esl-epfl/HEEPokranios-breakout-board/README.md

# This repository contains the HEEPokranios breakout board
