esl-epfl/HEEPokranios-breakout-board/gpio-playground/jlcpcb/production_files/BOM_gpio-playground.csv

Comment | Designator | Footprint | LCSC | Qty
100n | C1 | C_0603_1608Metric | C30926 | 1
LED | D0,D1,D2,D3,D4,D5,D6,D7,D9 | LED_0603_1608Metric | C84263 | 9
Conn_02x03_Odd_Even | J1 | PinHeader_2x03_P2.54mm_Horizontal | C41417351 | 1
Conn_02x08_Odd_Even | J2 | PinHeader_2x08_P2.54mm_Horizontal | C41417356 | 1
50k | R1,R2,R3,R4,R5,R6,R7,R8 | R_0603_1608Metric | C861451 | 8
1k | R9,R10,R11,R12,R13,R14,R15,R16,R17,R18,R19 | R_0603_1608Metric | C110776 | 11
SW_Push | SW0,SW1,SW2,SW3,SW4,SW5,SW6,SW7 | SW_Push_1P1T_NO_CK_KMR2 | C72443 | 8
BIWIN_DTS04GE_SMD | U1,U2 | BIWIN_DTS04GE_SMD | C3294670 | 2
74AHC244 | U3 | TSSOP-20_4.4x6.5mm_P0.65mm | C7475 | 1
