esl-epfl/HEEPokranios-breakout-board/(commit log)

2025-09-27 Previous to changing connector to 2.54
    [heepidermis-bo.kicad_pcb, heepidermis-bo.kicad_sch]
2025-09-27 Finished adding the large connector. Missing gpios and qfn footprint
    [heepidermis-bo.kicad_pcb, heepidermis-bo.kicad_sch]
2025-09-30 Almost done adding footprint of qfn64
    [heepidermis-bo.kicad_sch]
2025-10-01 DRC clean
    [heepidermis-bo.kicad_pcb, heepidermis-bo.kicad_sch]
2025-10-01 Uploaded gerbers
    [BOM_heepidermis-bo.csv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]
2025-10-03 Added zskin
    [heepidermis-bo-B_Cu.gbr, heepidermis-bo-B_Mask.gbr, heepidermis-bo-B_Paste.gbr, heepidermis-bo-B_Silkscreen.gbr, heepidermis-bo-Edge_Cuts.gbr, heepidermis-bo-F_Cu.gbr, heepidermis-bo-F_Mask.gbr, heepidermis-bo-F_Paste.gbr]
2025-11-18 Cleander repo
    [BOM_heepidermis-bo.csv, HEEPocrates.kicad_sch, LED_driver.kicad_sch, LevelTransMeasCurrent.kicad_sch, PowerHTB.kicad_sch, Programmer.kicad_sch, adc-dac.kicad_pcb, adc-dac.kicad_sch]
2026-07-14 further cleaning
    [BOM_heepidermis-bo.csv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]
2026-07-14 Added symbol and footprint of cheep boards connector
    [heepokranios-bo.kicad_sch]
2026-07-15 Initial draft of the schematic
    [heepokranios-bo.kicad_sch]
2026-07-15 Initial floorplannig
    [heepokranios-bo.kicad_sch]
2026-07-17 In the process of floorplanning the pcb
    [heepokranios-bo.kicad_pcb]
2026-07-17 Initial floorplanning
    [heepokranios-bo.kicad_pcb]
2026-07-17 Added GPIO playground extension board
    [gpio-playground.kicad_pcb, gpio-playground.kicad_sch, heepokranios-bo.kicad_pcb, heepokranios-bo.kicad_sch]
2026-07-17 Added gpio playground PCB
    [gpio-playground.kicad_pcb, gpio-playground.kicad_sch]
2026-07-17 Added first draft of portenta's extension board
    [portenta.kicad_pcb, portenta.kicad_sch]
2026-07-20 Adding sch block for analog fully-differential buffer
    [analog_buffers.kicad_sch]
2026-07-20 Added draft floorplan of portenta board
    [portenta.kicad_pcb, portenta.kicad_sch]
2026-07-20 notes on the portenta
    [portenta.kicad_pcb, portenta.kicad_sch]
2026-07-22 Added floorplan and outline of breakout board
    [fd_buffer.kicad_sch, heepokranios-bo.kicad_pcb, heepokranios-bo.kicad_sch, portenta.kicad_pcb, se_buffer.kicad_sch]
2026-07-22 Cheep connector (connections to main board): revised, modified 3V3 pin and added references to their values. Also modified the circuit to the current pins (resistor values + new pin headers)
    [heepokranios-bo.kicad_sch]
2026-07-23 Completed layout of the breakout board
    [heepokranios-bo.kicad_sch]
2026-07-23 Added logos to breakout
    [heepokranios-bo.kicad_sch]
2026-07-24 Updated connector on bo
    [gpio-playground.kicad_pcb, gpio-playground.kicad_sch, heepokranios-bo.kicad_sch]
2026-07-24 Corrected the pin connections of the playground
    [gpio-playground.kicad_pcb, gpio-playground.kicad_sch]
2026-07-24 Filled zones
    [gpio-playground.kicad_pcb]
2026-07-24 Revised connections between DMUX pins and Portenta
    [portenta.kicad_sch]
2026-07-27 Added matching circuit for antenna connector, and additional buffer for inputing SE and measuring FD
    [fd_buffer.kicad_sch, heepokranios-bo.kicad_pcb, heepokranios-bo.kicad_sch]
2026-07-27 Added 3d model of connector
    [heepokranios-bo.kicad_pcb]
2026-07-27 Added some 3d models to the PCB of the GPIO playground, not the real ones tho
    [gpio-playground.kicad_pcb]
2026-07-27 Placement in Portenta board, ready to route
    [portenta.kicad_pcb, portenta.kicad_sch]
2026-07-27 Layout of portenta board
    [portenta.kicad_pcb, portenta.kicad_sch]
2026-07-28 Portenta board: Edited footprints and added BOM for LCSC
    [BOM_portenta.csv, portenta.kicad_pcb, portenta.kicad_sch]
2026-07-28 GPIO playground board: Edited footprints and added BOM for LCSC
    [BOM_gpio-playground.csv]
2026-07-28 HEEPokranios breakout board: Added BOM for LCSC for all components except some pin headers and the chip socket
    [heepokranios-bo.csv]
2026-07-31 Changed NC pins to gnd connections of substrate as per the bonding diagram
    [heepokranios-bo.kicad_pcb, heepokranios-bo.kicad_sch]
2026-08-07 Edited footprint of PGA 13x13 socket to include lever area that was previously missing. Also upated BOM to reflect new VREF_EN pull-down resistor and lower resistor for heartbeat LED
    [heepokranios-bo.csv]
2026-08-07 Routing with extended PGA 13x13 socket
    [heepokranios-bo.kicad_pcb, heepokranios-bo.kicad_sch]
2026-08-07 Re-routed with updated PGA 13x13 socket
    [heepokranios-bo.kicad_pcb]
2026-08-07 Re-routed dMUX 0-7 pins from chip as they were inverted
    [heepokranios-bo.kicad_pcb, heepokranios-bo.kicad_sch]
2026-08-07 Added production files (gerbers and CPL) for JLCPCB for the GPIO playground board
    [gpio-playground.kicad_pcb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]
2026-08-07 Portenta board: Fixed DRCs in board and added production files (gerbers and CPL) for JLCPCB
    [portenta.kicad_pcb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]
2026-08-07 GPIO playground board: Fixed DRCs and shorts in dMUX pin header connections, and re-generated production files (CPL and gerbers)
    [gpio-playground.kicad_pcb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]
2026-08-07 Main breakout board: Generated production files (CPL, gerber) for JLCPCB
    [BOM_heepokranios-bo.csv, heepokranios-bo.kicad_pcb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]
2026-08-12 Edited LCSC code for 3x3p male pin header
    [BOM_heepokranios-bo.csv]
2026-08-12 Changed in sch and board the fully diff amplifiers within the buffers to the THS4551IRGTR as there was no more stock of the one from Analog Devices
    [fd_buffer.kicad_sch, heepokranios-bo.kicad_pcb, se_buffer.kicad_sch]
2026-08-12 Updated production files for JLCPCB with the new fully differential amplifier for the buffers
    [BOM_heepokranios-bo.csv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]
2026-08-13 Changed push button model to one that has stock
    [BOM_gpio-playground.csv]
