esl-epfl/HEEPokranios-breakout-board/heepokranios-bo/heepokranios-bo.kicad_pcb

## KiCad design heepokranios-bo/heepokranios-bo.kicad_pcb (2026-08-12)

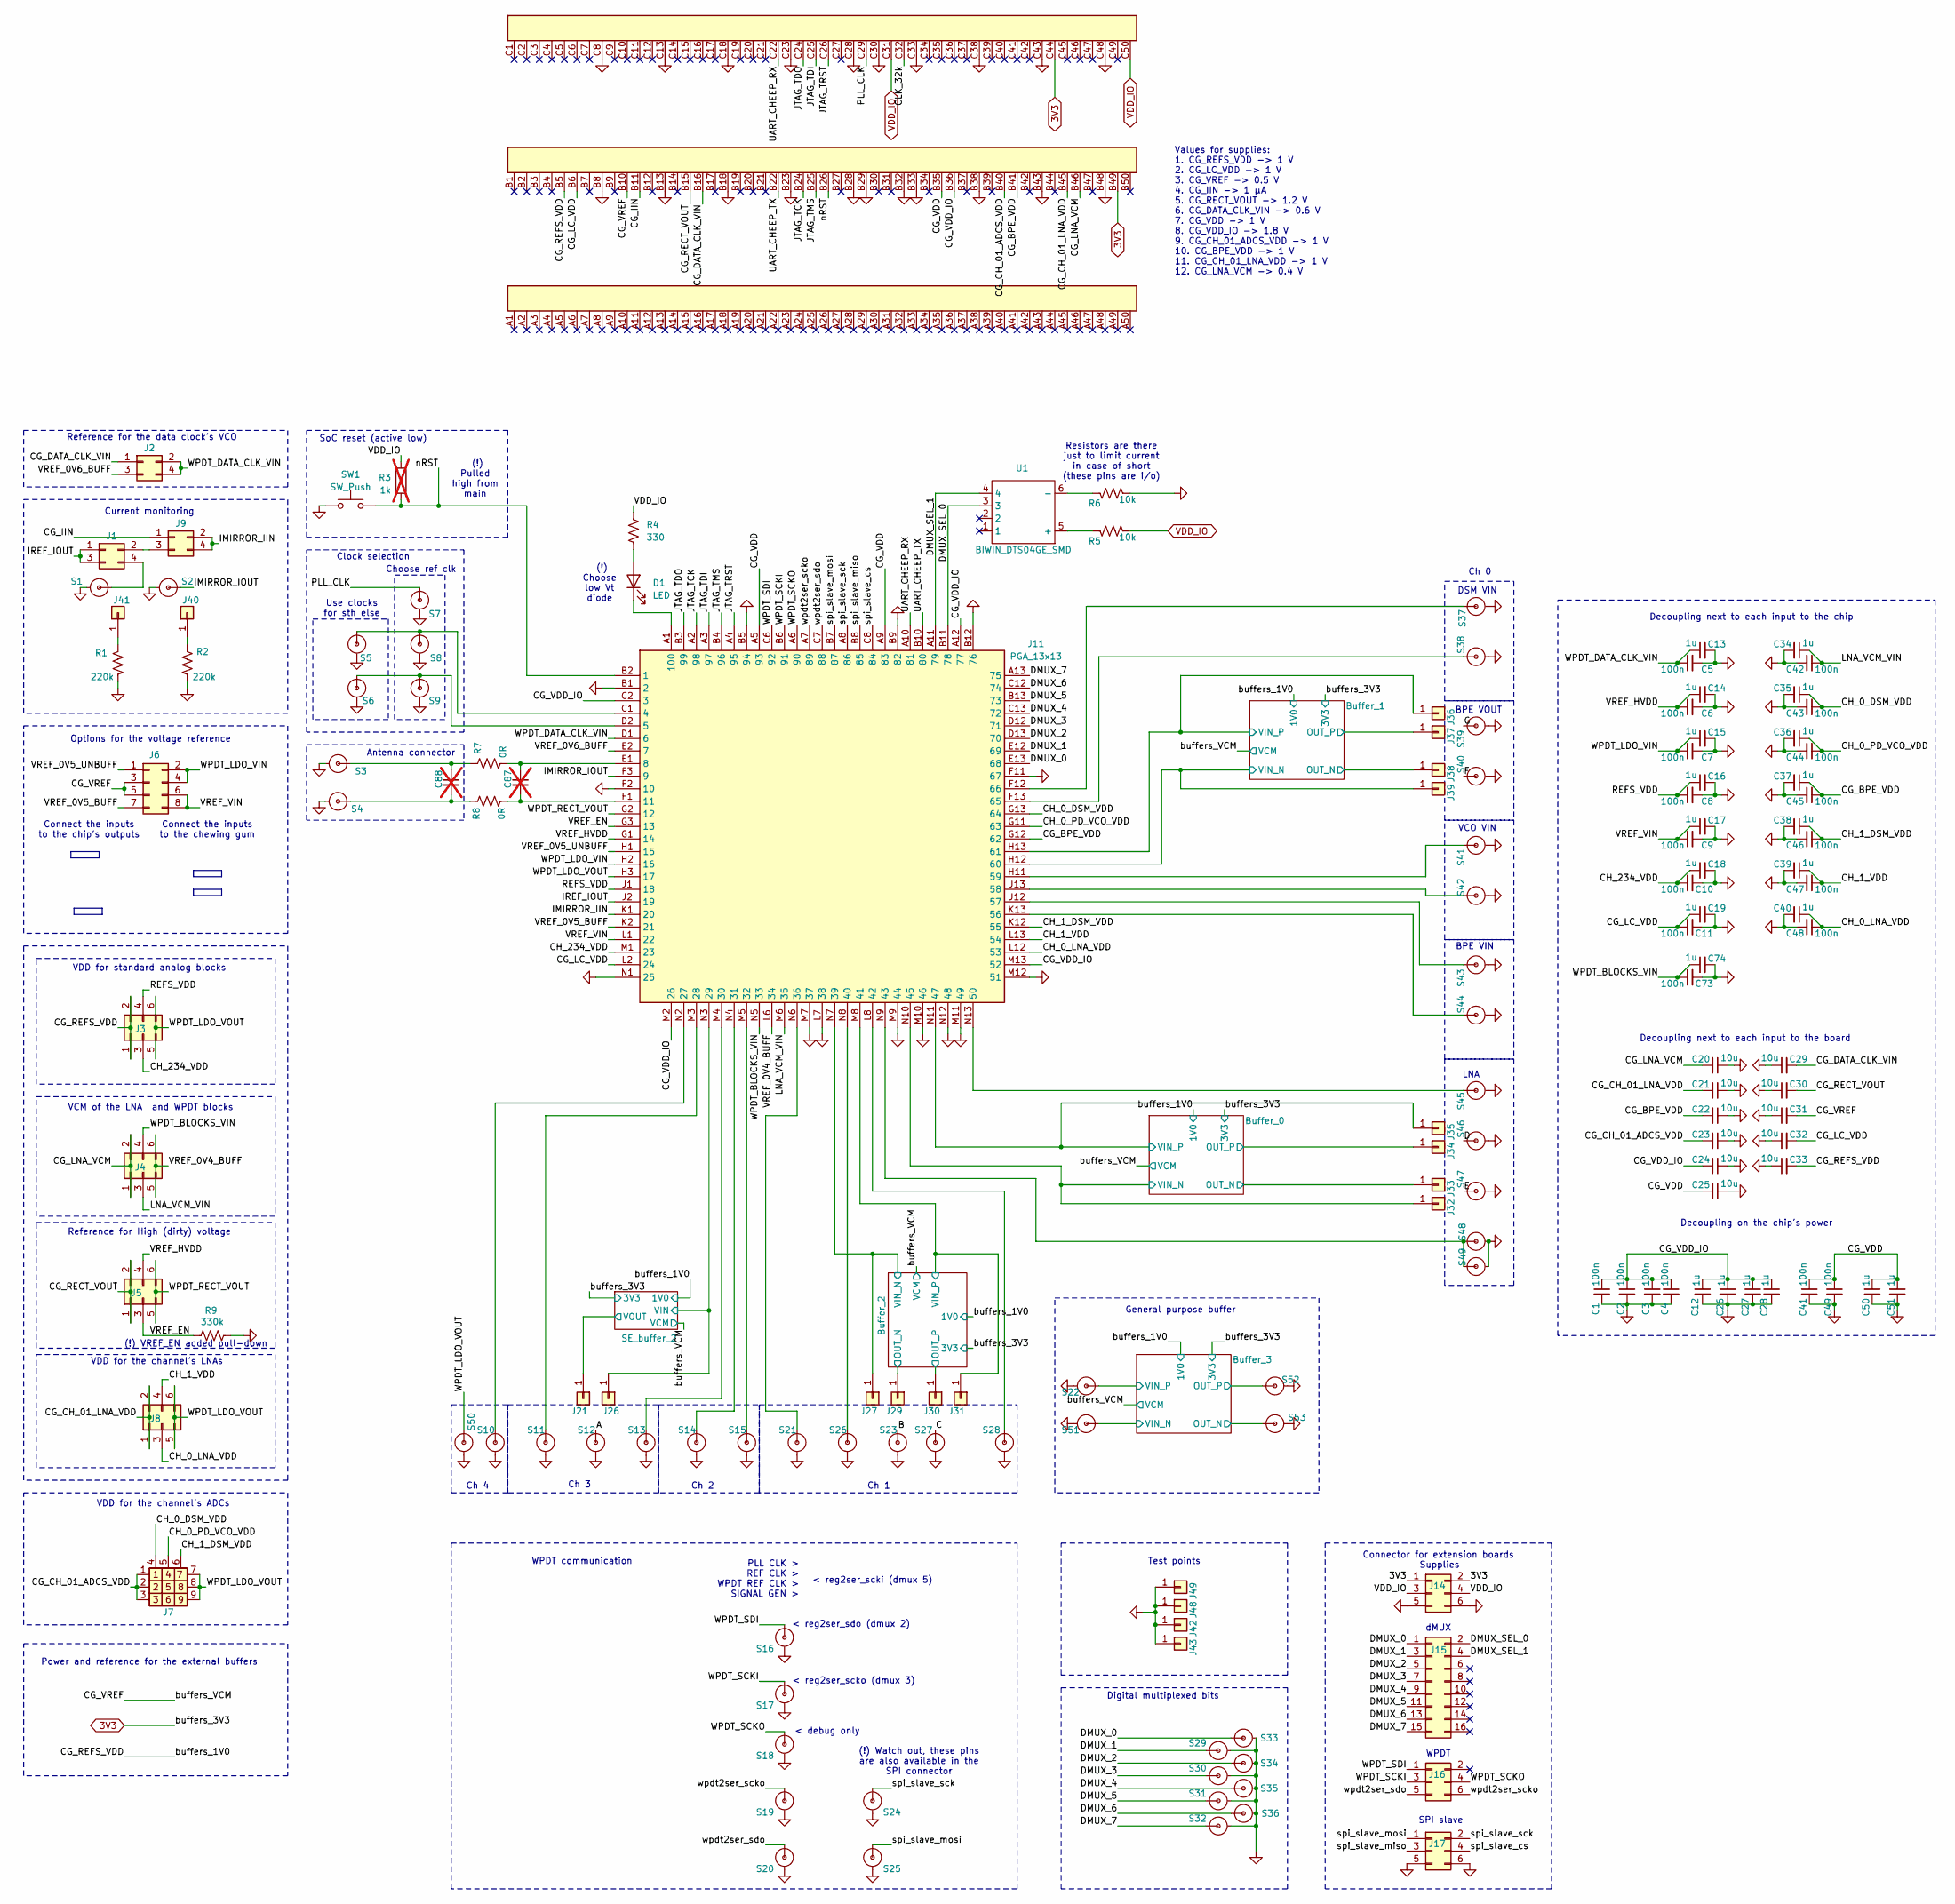
[picture p1: schematic heepokranios-bo.kicad_sch]

Parts:
C1, C2, C3, C4, C5, C6, C7, C8, C9, C10, C11, C41, C42, C43, C44, C45, C46, C47, C48, C49, C73: 100n; C_0603_1608Metric; Mouser Part Number 80-C0805C104Z3V; Digikey Part Number 399-9158-1-ND
C12, C13, C14, C15, C16, C17, C18, C19, C26, C27, C28, C34, C35, C36, C37, C38, C39, C40, C50, C51, C74: 1u; C_0603_1608Metric; Mouser Part Number 80-C0805C104Z3V; Digikey Part Number 399-9158-1-ND
C20, C21, C22, C23, C24, C25, C29, C30, C31, C32, C33: 10u; C_0603_1608Metric; Mouser Part Number 80-C0805C104Z3V; Digikey Part Number 399-9158-1-ND
C87, C88: C_0805_2012Metric_Pad1.18x1.45mm_HandSolder; Mouser Part Number 80-C0805C104Z3V; Digikey Part Number 399-9158-1-ND; not fitted
D1: LED; LED_0603_1608Metric
J1, J2, J9: Conn_02x02_Odd_Even; PinHeader_2x02_P2.54mm_Vertical
J3, J4, J5, J8: Conn_02x03_Odd_Even; PinHeader_2x03_P2.54mm_Vertical
J6: Conn_02x04_Odd_Even; PinHeader_2x04_P2.54mm_Vertical
J7: Conn_3x03
J10: cheep_board_connector
J11: PGA_13x13; Mouser Part Number 535-100-PGM13061-10
J14, J16, J17: Conn_02x03_Odd_Even; PinSocket_2x03_P2.54mm_Horizontal
J15: Conn_02x08_Odd_Even; PinSocket_2x08_P2.54mm_Horizontal
J21, J26, J27, J29, J30, J31, J32, J33, J34, J35, J36, J37, J38, J39, J40, J41, J42, J43, J48, J49: Conn_01x02; PinHeader_1x01_P2.54mm_Vertical
R1, R2: 220k; R_0603_1608Metric
R3: 1k; R_0603_1608Metric; LCSC C21190; not fitted
R4: 330; R_0603_1608Metric
R5, R6: 10k; R_0603_1608Metric
R7, R8: 0R; R_0603_1608Metric
R9: 330k; R_0603_1608Metric
S1, S2, S3, S4, S5, S6, S7, S8, S9, S10, S11, S12, S13, S14, S15, S16, S17, S18, S19, S20, S21, S22, S23, S24, S25, S26, S27, S28, S29, S30, S31, S32, S33, S34, S35, S36, S37, S38, S39, S40, S41, S42, S43, S44, S45, S46, S47, S48, S49, S50, S51, S52, S53: SMA connector; SMA_w_tp
SW1: SW_Push; SW_Push_1P1T_NO_CK_KMR2
U1: BIWIN_DTS04GE_SMD; lcsc C3294670

Connections:
3V3: J10.B49, J10.C44, J14.1, J14.2; also elsewhere on the board
/A: S12.1
/B: S23.1
/Buffer_0/OUT_N: J33.1 (Pin_1_1); also elsewhere on the board
/Buffer_0/OUT_P: J34.1 (Pin_1_1); also elsewhere on the board
/Buffer_0/VIN_N: J11.N10 (45), J32.1 (Pin_1_1); also elsewhere on the board
/Buffer_0/VIN_P: J11.N11 (47), J35.1 (Pin_1_1); also elsewhere on the board
/Buffer_1/OUT_N: J38.1 (Pin_1_1); also elsewhere on the board
/Buffer_1/OUT_P: J37.1 (Pin_1_1); also elsewhere on the board
/Buffer_1/VIN_N: J11.H12 (60), J39.1 (Pin_1_1); also elsewhere on the board
/Buffer_1/VIN_P: J11.H13 (61), J36.1 (Pin_1_1); also elsewhere on the board
/Buffer_2/OUT_N: J29.1 (Pin_1_1); also elsewhere on the board
/Buffer_2/OUT_P: J30.1 (Pin_1_1); also elsewhere on the board
/Buffer_2/VIN_N: J11.N7 (39), J27.1 (Pin_1_1); also elsewhere on the board
/Buffer_2/VIN_P: J11.M8 (41), J31.1 (Pin_1_1); also elsewhere on the board
/Buffer_3/OUT_N: S53.1; also elsewhere on the board
/Buffer_3/OUT_P: S52.1; also elsewhere on the board
/Buffer_3/VIN_N: S51.1; also elsewhere on the board
/Buffer_3/VIN_P: S22.1; also elsewhere on the board
/C: S27.1
/CG_BPE_VDD: C22.2, C37.1, C45.1, J10.B41, J11.G12 (62)
/CG_CH_01_ADCS_VDD: C23.2, J7.1, J7.2, J7.3, J10.B40
/CG_CH_01_LNA_VDD: C21.2, J8.1, J8.2, J10.B45
/CG_DATA_CLK_VIN: C29.2, J2.1, J10.B16
/CG_IIN: J9.1, J10.B11
/CG_LC_VDD: C11.1, C19.1, C32.2, J10.B6, J11.L2 (24)
/CG_LNA_VCM: C20.2, J4.1, J4.2, J10.B46
/CG_RECT_VOUT: C30.2, J5.1, J5.2, J10.B15
/CG_REFS_VDD: C33.2, J3.1, J3.2, J10.B5; also elsewhere on the board
/CG_VDD: C25.2, C41.1, C49.1, C50.1, C51.1, J10.B35, J11.A5 (93), J11.A9 (83)
/CG_VDD_IO: C1.1, C2.1, C3.1, C4.1, C12.1, C24.2, C26.1, C27.1, C28.1, J10.B36, J11.A12 (77), J11.C2 (3), J11.M2 (26), J11.M13 (52)
/CG_VREF: C31.2, J6.3, J6.5, J10.B10; also elsewhere on the board
/CH_0_DSM_VDD: C35.1, C43.1, J7.4, J11.G13 (64)
/CH_0_LNA_VDD: C40.1, C48.1, J8.3, J11.L12 (53)
/CH_0_PD_VCO_VDD: C36.1, C44.1, J7.5, J11.G11 (63)
/CH_1_DSM_VDD: C38.1, C46.1, J7.6, J11.K12 (55)
/CH_1_VDD: C39.1, C47.1, J8.4, J11.L13 (54)
/CH_234_VDD: C10.1, C18.1, J3.3, J11.M1 (23)
/CLK_32k: J10.C32
/D: S46.1
/DMUX_0: J11.E13 (68), J15.1, S33.1
/DMUX_1: J11.E12 (69), J15.3, S29.1
/DMUX_2: J11.D13 (70), J15.5, S34.1
/DMUX_3: J11.D12 (71), J15.7, S30.1
/DMUX_4: J11.C13 (72), J15.9, S35.1
/DMUX_5: J11.B13 (73), J15.11, S31.1
/DMUX_6: J11.C12 (74), J15.13, S36.1
/DMUX_7: J11.A13 (75), J15.15, S32.1
/DMUX_SEL_0: J11.B11 (78), J15.2, U1.3
/DMUX_SEL_1: J11.A11 (79), J15.4, U1.4
/E: S47.1
/F: S40.1
/G: S39.1
/IMIRROR_IIN: J9.2, J9.4, J11.K1 (20)
/IMIRROR_IOUT: J11.F3 (9), S2.1
/IREF_IOUT: J1.1, J1.3, J11.J2 (19)
/JTAG_TCK: J10.B24, J11.A2 (98)
/JTAG_TDI: J10.C25, J11.A3 (97)
/JTAG_TDO: J10.C24, J11.B3 (99)
/JTAG_TMS: J10.B25, J11.B4 (96)
/JTAG_TRST: J10.C26, J11.A4 (95)
/LNA_VCM_VIN: C34.1, C42.1, J4.3, J11.M6 (35)
/PLL_CLK: J10.C29, S7.1
/REFS_VDD: C8.1, C16.1, J3.4, J11.J1 (18)
/SE_buffer_2/VIN: J11.N3 (29), J26.1 (Pin_1_1); also elsewhere on the board
/SE_buffer_2/VOUT: J21.1 (Pin_1_1); also elsewhere on the board
/UART_CHEEP_RX: J10.C22, J11.A10 (81)
/UART_CHEEP_TX: J10.B22, J11.B10 (80)
/VREF_0V4_BUFF: J4.5, J4.6, J11.L6 (34)
/VREF_0V5_BUFF: J6.7, J11.K2 (21)
/VREF_0V5_UNBUFF: J6.1, J11.H1 (15)
/VREF_0V6_BUFF: J2.3, J11.E2 (7)
/VREF_EN: J5.3, J11.G3 (13), R9.1
/VREF_HVDD: C6.1, C14.1, J5.4, J11.G1 (14)
/VREF_VIN: C9.1, C17.1, J6.6, J6.8, J11.L1 (22)
/WPDT_BLOCKS_VIN: C73.1, C74.1, J4.4, J11.N5 (33)
/WPDT_DATA_CLK_VIN: C5.1, C13.1, J2.2, J2.4, J11.D1 (6)
/WPDT_LDO_VIN: C7.1, C15.1, J6.2, J6.4, J11.H2 (16)
/WPDT_LDO_VOUT: J3.5, J3.6, J7.7, J7.8, J7.9, J8.5, J8.6, J11.H3 (17), S50.1
/WPDT_RECT_VOUT: J5.5, J5.6, J11.G2 (12)
/WPDT_SCKI: J11.B6 (91), J16.3, S17.1
/WPDT_SCKO: J11.A6 (90), J16.4, S18.1
/WPDT_SDI: J11.C6 (92), J16.1, S16.1
/nRST: J10.B26, J11.B2 (1), R3.1, SW1.1
/spi_slave_cs: J11.C8 (84), J17.4
/spi_slave_miso: J11.B8 (85), J17.3
/spi_slave_mosi: J11.B7 (87), J17.1, S25.1
/spi_slave_sck: J11.A8 (86), J17.2, S24.1
/wpdt2ser_scko: J11.A7 (89), J16.6, S19.1
/wpdt2ser_sdo: J11.C7 (88), J16.5, S20.1
GND: C1.2, C2.2, C3.2, C4.2, C5.2, C6.2, C7.2, C8.2, C9.2, C10.2, C11.2, C12.2, C13.2, C14.2, C15.2, C16.2, C17.2, C18.2, C19.2, C20.1, C21.1, C22.1, C23.1, C24.1, C25.1, C26.2, C27.2, C28.2, C29.1, C30.1, C31.1, C32.1, C33.1, C34.2, C35.2, C36.2, C37.2, C38.2, C39.2, C40.2, C41.2, C42.2, C43.2, C44.2, C45.2, C46.2, C47.2, C48.2, C49.2, C50.2, C51.2, C73.2, C74.2, J10.B8, J10.B13, J10.B18, J10.B23, J10.B28, J10.B29, J10.B32, J10.B33, J10.B38, J10.B43, J10.B48, J10.C8, J10.C13, J10.C18, J10.C23, J10.C28, J10.C30, J10.C33, J10.C38, J10.C43, J10.C48, J11.B1 (2), J11.B5 (94), J11.B9 (82), J11.B12 (76), J11.F2 (10), J11.F11 (67), J11.L7 (38), J11.M7 (37), J11.M9 (44), J11.M10 (46), J11.M11 (49), J11.M12 (51), J11.N1 (25), J11.N12 (48), J14.5, J14.6, J17.5, J17.6, J42.1 (Pin_1_1), J43.1 (Pin_1_1), J48.1 (Pin_1_1), J49.1 (Pin_1_1), R1.2, R2.2, R6.2, R9.2, S1.2, S2.2, S3.2, S4.2, S5.2, S6.2, S7.2, S8.2, S9.2, S10.2, S11.2, S12.2, S13.2, S14.2, S15.2, S16.2, S17.2, S18.2, S19.2, S20.2, S21.2, S22.2, S23.2, S24.2, S25.2, S26.2, S27.2, S28.2, S29.2, S30.2, S31.2, S32.2, S33.2, S34.2, S35.2, S36.2, S37.2, S38.2, S39.2, S40.2, S41.2, S42.2, S43.2, S44.2, S45.2, S46.2, S47.2, S48.2, S49.2, S50.2, S51.2, S52.2, S53.2, SW1.2; also elsewhere on the board
unnamed: C88.1, R7.1, S3.1
unnamed: C88.2, R8.1, S4.1
unnamed: D1.2 (A), R4.2
unnamed: D1.1 (K), J11.A1 (100)
unnamed: J1.2, J9.3
unnamed: J1.4, S1.1
unnamed: J11.C1 (4), S5.1, S8.1
unnamed: J11.D2 (5), S6.1, S9.1
unnamed: C87.1, J11.E1 (8), R7.2
unnamed: C87.2, J11.F1 (11), R8.2
unnamed: J11.N2 (27), S10.1
unnamed: J11.M3 (28), S11.1
unnamed: J11.M4 (30), S13.1
unnamed: J11.N4 (31), S14.1
unnamed: J11.M5 (32), S15.1
unnamed: J11.N6 (36), S21.1
unnamed: J11.N8 (40), S26.1
unnamed: J11.L8 (42), S28.1
unnamed: J11.N9 (43), S48.1, S49.1
unnamed: J11.N13 (50), S45.1
unnamed: J11.K13 (56), S44.1
unnamed: J11.J12 (57), S43.1
unnamed: J11.J13 (58), S42.1
unnamed: J11.H11 (59), S41.1
unnamed: J11.F13 (65), S38.1
unnamed: J11.F12 (66), S37.1
unnamed: J40.1 (Pin_1_1), R2.1
unnamed: J41.1 (Pin_1_1), R1.1
unnamed: R5.1, U1.5 (+)
unnamed: R6.1, U1.6 (-)
VDD_IO: J10.C31, J10.C50, J14.3, J14.4, R3.2, R4.1, R5.2

Notes on the sheet:
LNA
Ch 1
Values for supplies: 1. CG_REFS_VDD -> 1 V 2. CG_LC_VDD -> 1 V 3. CG_VREF -> 0.5 V 4. CG_IIN -> 1 μA 5. CG_RECT_VOUT -> 1.2 V 6. CG_DATA_CLK_VIN -> 0.6 V 7. CG_VDD -> 1 V 8. CG_VDD_IO -> 1.8 V 9. CG_CH_01_ADCS_VDD -> 1 V 10. CG_BPE_VDD -> 1 V 11. CG_CH_01_LNA_VDD -> 1 V 12. CG_LNA_VCM -> 0.4 V
Digital multiplexed bits
(!) Choose low Vt diode
Ch 0
Clock selection
Connector for extension boards
WPDT communication
SPI slave
VCM of the LNA and WPDT blocks
Decoupling on the chip's power
PLL CLK > REF CLK > WPDT REF CLK > SIGNAL GEN >
Test points
VDD for the channel's ADCs
BPE VOUT
< reg2ser_scki (dmux 5)
< reg2ser_sdo (dmux 2)
Use clocks for sth else
Power and reference for the external buffers
VDD for standard analog blocks
Options for the voltage reference
Choose ref clk
< reg2ser_scko (dmux 3)
Current monitoring
Ch 2
dMUX
Ch 4
Decoupling next to each input to the chip
BPE VIN
SoC reset (active low)
Ch 3
VCO VIN
DSM VIN
< debug only
VDD for the channel's LNAs
(!) VREF_EN added pull-down
Reference for the data clock's VCO
Connect the inputs to the chewing gum
WPDT
General purpose buffer
Resistors are there just to limit current in case of short (these pins are i/o)
Connect the inputs to the chip's outputs
(!) Pulled high from main
Reference for High (dirty) voltage
(!) Watch out, these pins are also available in the SPI connector
Decoupling next to each input to the board
Antenna connector
Supplies

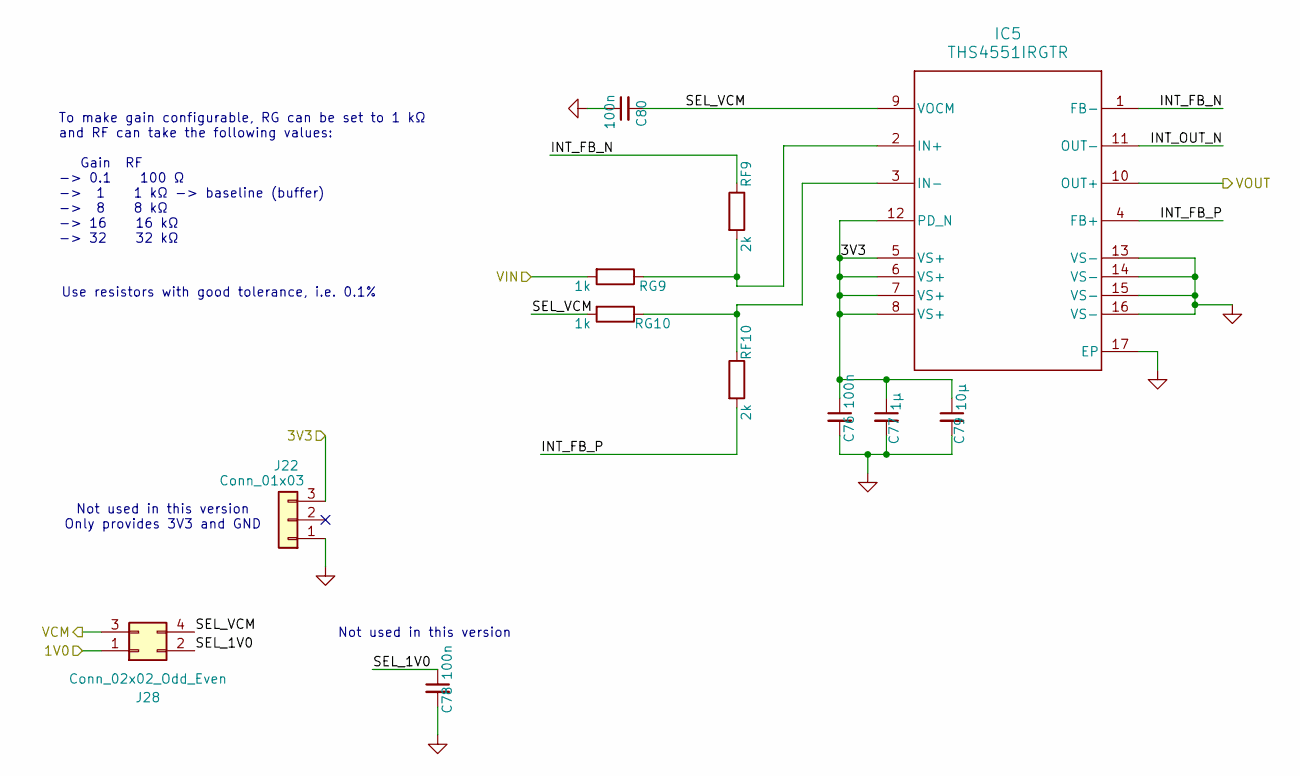
[picture p2: schematic se_buffer.kicad_sch]

Parts:
C76, C78, C80: 100n; C_0603_1608Metric; Mouser Part Number 80-C0805C104Z3V; Digikey Part Number 399-9158-1-ND
C77: 1μ; C_0603_1608Metric; Mouser Part Number 80-C0805C104Z3V; Digikey Part Number 399-9158-1-ND
C79: 10μ; C_0603_1608Metric; Mouser Part Number 80-C0805C104Z3V; Digikey Part Number 399-9158-1-ND
IC5: THS4551IRGTR; RGT0016C
J22: Conn_01x03; PinHeader_1x03_P2.54mm_Vertical
J28: Conn_02x02_Odd_Even; PinHeader_2x02_P2.54mm_Vertical
RF9, RF10: 2k; R_0603_1608Metric; LCSC C22975
RG9, RG10: 1k; R_0603_1608Metric; LCSC C22975

Connections:
3V3: C76.1, C77.1, C79.1, IC5.5 (VS+), IC5.6 (VS+), IC5.7 (VS+), IC5.8 (VS+), IC5.12 (PD_N), J22.3; also elsewhere on the board
/CG_REFS_VDD: J28.1; also elsewhere on the board
/CG_VREF: J28.3; also elsewhere on the board
/SE_buffer_2/INT_FB_N: IC5.1 (FB-), RF9.1
/SE_buffer_2/INT_FB_P: IC5.4 (FB+), RF10.2
/SE_buffer_2/INT_OUT_N: IC5.11 (OUT-)
/SE_buffer_2/SEL_1V0: C78.1, J28.2
/SE_buffer_2/SEL_VCM: C80.2, IC5.9 (VOCM), J28.4, RG10.2
/SE_buffer_2/VIN: RG9.2; also elsewhere on the board
/SE_buffer_2/VOUT: IC5.10 (OUT+); also elsewhere on the board
GND: C76.2, C77.2, C78.2, C79.2, C80.1, IC5.13 (VS-), IC5.14 (VS-), IC5.15 (VS-), IC5.16 (VS-), IC5.17 (EP), J22.1; also elsewhere on the board
unnamed: IC5.2 (IN+), RF9.2, RG9.1
unnamed: IC5.3 (IN-), RF10.1, RG10.1

Notes on the sheet:
To make gain configurable, RG can be set to 1 kΩ and RF can take the following values: Gain RF -> 0.1 100 Ω -> 1 1 kΩ -> baseline (buffer) -> 8 8 kΩ -> 16 16 kΩ -> 32 32 kΩ
Not used in this version Only provides 3V3 and GND
Not used in this version
Use resistors with good tolerance, i.e. 0.1%

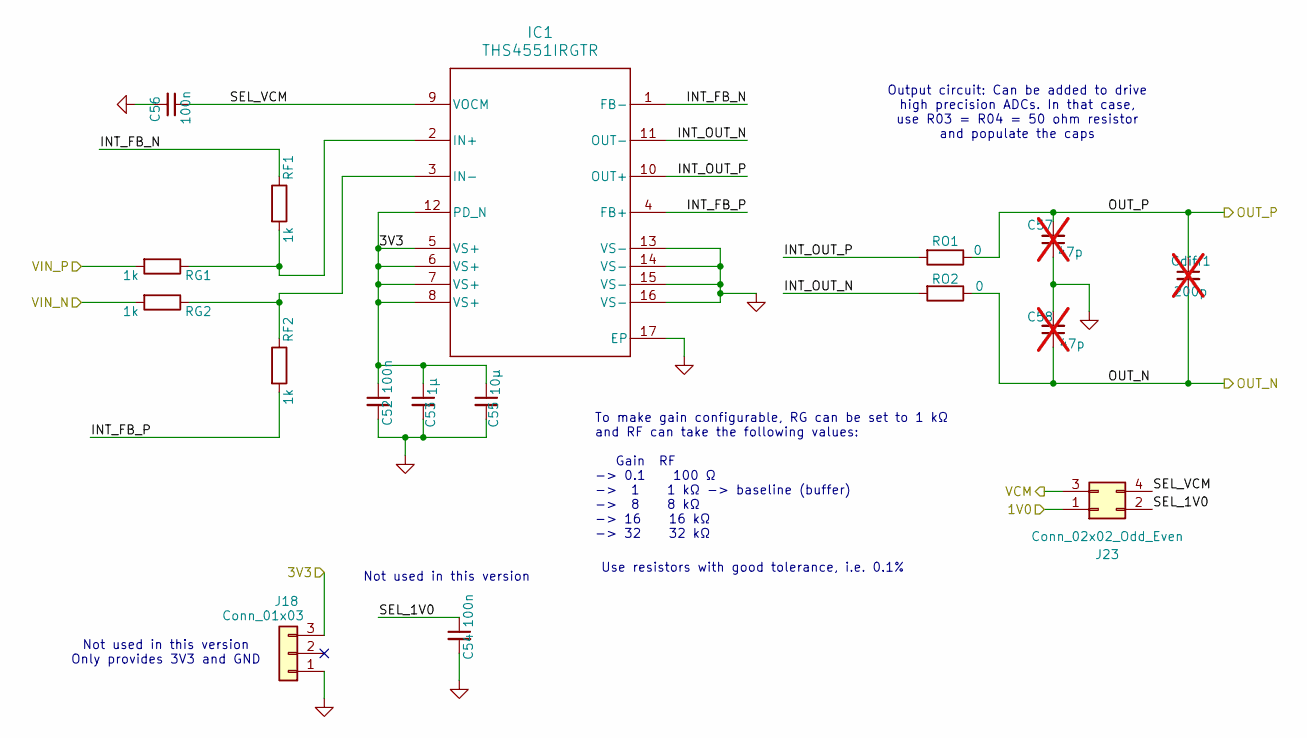
[picture p3: schematic fd_buffer.kicad_sch]

Parts:
C52, C54, C56: 100n; C_0603_1608Metric; Mouser Part Number 80-C0805C104Z3V; Digikey Part Number 399-9158-1-ND
C53: 1μ; C_0603_1608Metric; Mouser Part Number 80-C0805C104Z3V; Digikey Part Number 399-9158-1-ND
C55: 10μ; C_0603_1608Metric; Mouser Part Number 80-C0805C104Z3V; Digikey Part Number 399-9158-1-ND
C57, C58: 47p; C_0603_1608Metric; Mouser Part Number 80-C0805C104Z3V; Digikey Part Number 399-9158-1-ND; not fitted
Cdiff1: 200p; C_0603_1608Metric; Mouser Part Number 80-C0805C104Z3V; Digikey Part Number 399-9158-1-ND; not fitted
IC1: THS4551IRGTR; RGT0016C
J18: Conn_01x03; PinHeader_1x03_P2.54mm_Vertical
J23: Conn_02x02_Odd_Even; PinHeader_2x02_P2.54mm_Vertical
RF1, RF2: 1k; R_0603_1608Metric; LCSC C22975
RG1, RG2: 1k; R_0603_1608Metric; LCSC C22975
RO1, RO2: 0; R_0603_1608Metric; LCSC C22975

Connections:
3V3: C52.1, C53.1, C55.1, IC1.5 (VS+), IC1.6 (VS+), IC1.7 (VS+), IC1.8 (VS+), IC1.12 (PD_N), J18.3; also elsewhere on the board
/Buffer_0/INT_FB_N: IC1.1 (FB-), RF1.1
/Buffer_0/INT_FB_P: IC1.4 (FB+), RF2.2
/Buffer_0/INT_OUT_N: IC1.11 (OUT-), RO2.2
/Buffer_0/INT_OUT_P: IC1.10 (OUT+), RO1.2
/Buffer_0/OUT_N: C58.1, Cdiff1.2, RO2.1; also elsewhere on the board
/Buffer_0/OUT_P: C57.2, Cdiff1.1, RO1.1; also elsewhere on the board
/Buffer_0/SEL_1V0: C54.1, J23.2
/Buffer_0/SEL_VCM: C56.1, IC1.9 (VOCM), J23.4
/Buffer_0/VIN_N: RG2.2; also elsewhere on the board
/Buffer_0/VIN_P: RG1.2; also elsewhere on the board
/CG_REFS_VDD: J23.1; also elsewhere on the board
/CG_VREF: J23.3; also elsewhere on the board
GND: C52.2, C53.2, C54.2, C55.2, C56.2, C57.1, C58.2, IC1.13 (VS-), IC1.14 (VS-), IC1.15 (VS-), IC1.16 (VS-), IC1.17 (EP), J18.1; also elsewhere on the board
unnamed: IC1.2 (IN+), RF1.2, RG1.1
unnamed: IC1.3 (IN-), RF2.1, RG2.1

Parts of its further copies:
C59, C61, C63, C66, C68, C70, C75, C82, C84: 100n; C_0603_1608Metric; Mouser Part Number 80-C0805C104Z3V; Digikey Part Number 399-9158-1-ND
C60, C67, C81: 1μ; C_0603_1608Metric; Mouser Part Number 80-C0805C104Z3V; Digikey Part Number 399-9158-1-ND
C62, C69, C83: 10μ; C_0603_1608Metric; Mouser Part Number 80-C0805C104Z3V; Digikey Part Number 399-9158-1-ND
C64, C65, C71, C72, C85, C86: 47p; C_0603_1608Metric; Mouser Part Number 80-C0805C104Z3V; Digikey Part Number 399-9158-1-ND; not fitted
Cdiff2, Cdiff3, Cdiff4: 200p; C_0603_1608Metric; Mouser Part Number 80-C0805C104Z3V; Digikey Part Number 399-9158-1-ND; not fitted
IC2, IC3, IC4: THS4551IRGTR; RGT0016C
J19, J20, J45: Conn_01x03; PinHeader_1x03_P2.54mm_Vertical
J24, J25, J44: Conn_02x02_Odd_Even; PinHeader_2x02_P2.54mm_Vertical
RF3, RF4, RF5, RF6, RF7, RF8: 1k; R_0603_1608Metric; LCSC C22975
RG3, RG4, RG5, RG6, RG7, RG8: 1k; R_0603_1608Metric; LCSC C22975
RO3, RO4, RO5, RO6, RO7, RO8: 0; R_0603_1608Metric; LCSC C22975

Connections of its further copies:
3V3: C59.1, C60.1, C62.1, C66.1, C67.1, C69.1, C75.1, C81.1, C83.1, IC2.5 (VS+), IC2.6 (VS+), IC2.7 (VS+), IC2.8 (VS+), IC2.12 (PD_N), IC3.5 (VS+), IC3.6 (VS+), IC3.7 (VS+), IC3.8 (VS+), IC3.12 (PD_N), IC4.5 (VS+), IC4.6 (VS+), IC4.7 (VS+), IC4.8 (VS+), IC4.12 (PD_N), J19.3, J20.3, J45.3; also elsewhere on the board
/Buffer_1/INT_FB_N: IC2.1 (FB-), RF3.1
/Buffer_1/INT_FB_P: IC2.4 (FB+), RF4.2
/Buffer_1/INT_OUT_N: IC2.11 (OUT-), RO4.2
/Buffer_1/INT_OUT_P: IC2.10 (OUT+), RO3.2
/Buffer_1/OUT_N: C65.1, Cdiff2.2, RO4.1; also elsewhere on the board
/Buffer_1/OUT_P: C64.2, Cdiff2.1, RO3.1; also elsewhere on the board
/Buffer_1/SEL_1V0: C61.1, J24.2
/Buffer_1/SEL_VCM: C63.1, IC2.9 (VOCM), J24.4
/Buffer_1/VIN_N: RG4.2; also elsewhere on the board
/Buffer_1/VIN_P: RG3.2; also elsewhere on the board
/Buffer_2/INT_FB_N: IC3.1 (FB-), RF5.1
/Buffer_2/INT_FB_P: IC3.4 (FB+), RF6.2
/Buffer_2/INT_OUT_N: IC3.11 (OUT-), RO6.2
/Buffer_2/INT_OUT_P: IC3.10 (OUT+), RO5.2
/Buffer_2/OUT_N: C72.1, Cdiff3.2, RO6.1; also elsewhere on the board
/Buffer_2/OUT_P: C71.2, Cdiff3.1, RO5.1; also elsewhere on the board
/Buffer_2/SEL_1V0: C68.1, J25.2
/Buffer_2/SEL_VCM: C70.1, IC3.9 (VOCM), J25.4
/Buffer_2/VIN_N: RG6.2; also elsewhere on the board
/Buffer_2/VIN_P: RG5.2; also elsewhere on the board
/Buffer_3/INT_FB_N: IC4.1 (FB-), RF7.1
/Buffer_3/INT_FB_P: IC4.4 (FB+), RF8.2
/Buffer_3/INT_OUT_N: IC4.11 (OUT-), RO8.2
/Buffer_3/INT_OUT_P: IC4.10 (OUT+), RO7.2
/Buffer_3/OUT_N: C86.1, Cdiff4.2, RO8.1; also elsewhere on the board
/Buffer_3/OUT_P: C85.2, Cdiff4.1, RO7.1; also elsewhere on the board
/Buffer_3/SEL_1V0: C82.1, J44.2
/Buffer_3/SEL_VCM: C84.1, IC4.9 (VOCM), J44.4
/Buffer_3/VIN_N: RG8.2; also elsewhere on the board
/Buffer_3/VIN_P: RG7.2; also elsewhere on the board
/CG_REFS_VDD: J24.1, J25.1, J44.1; also elsewhere on the board
/CG_VREF: J24.3, J25.3, J44.3; also elsewhere on the board
GND: C59.2, C60.2, C61.2, C62.2, C63.2, C64.1, C65.2, C66.2, C67.2, C68.2, C69.2, C70.2, C71.1, C72.2, C75.2, C81.2, C82.2, C83.2, C84.2, C85.1, C86.2, IC2.13 (VS-), IC2.14 (VS-), IC2.15 (VS-), IC2.16 (VS-), IC2.17 (EP), IC3.13 (VS-), IC3.14 (VS-), IC3.15 (VS-), IC3.16 (VS-), IC3.17 (EP), IC4.13 (VS-), IC4.14 (VS-), IC4.15 (VS-), IC4.16 (VS-), IC4.17 (EP), J19.1, J20.1, J45.1; also elsewhere on the board
unnamed: IC2.2 (IN+), RF3.2, RG3.1
unnamed: IC2.3 (IN-), RF4.1, RG4.1
unnamed: IC3.2 (IN+), RF5.2, RG5.1
unnamed: IC3.3 (IN-), RF6.1, RG6.1
unnamed: IC4.2 (IN+), RF7.2, RG7.1
unnamed: IC4.3 (IN-), RF8.1, RG8.1

Notes on the sheet:
Use resistors with good tolerance, i.e. 0.1%
Not used in this version Only provides 3V3 and GND
Output circuit: Can be added to drive high precision ADCs. In that case, use R03 = R04 = 50 ohm resistor and populate the caps
To make gain configurable, RG can be set to 1 kΩ and RF can take the following values: Gain RF -> 0.1 100 Ω -> 1 1 kΩ -> baseline (buffer) -> 8 8 kΩ -> 16 16 kΩ -> 32 32 kΩ
Not used in this version

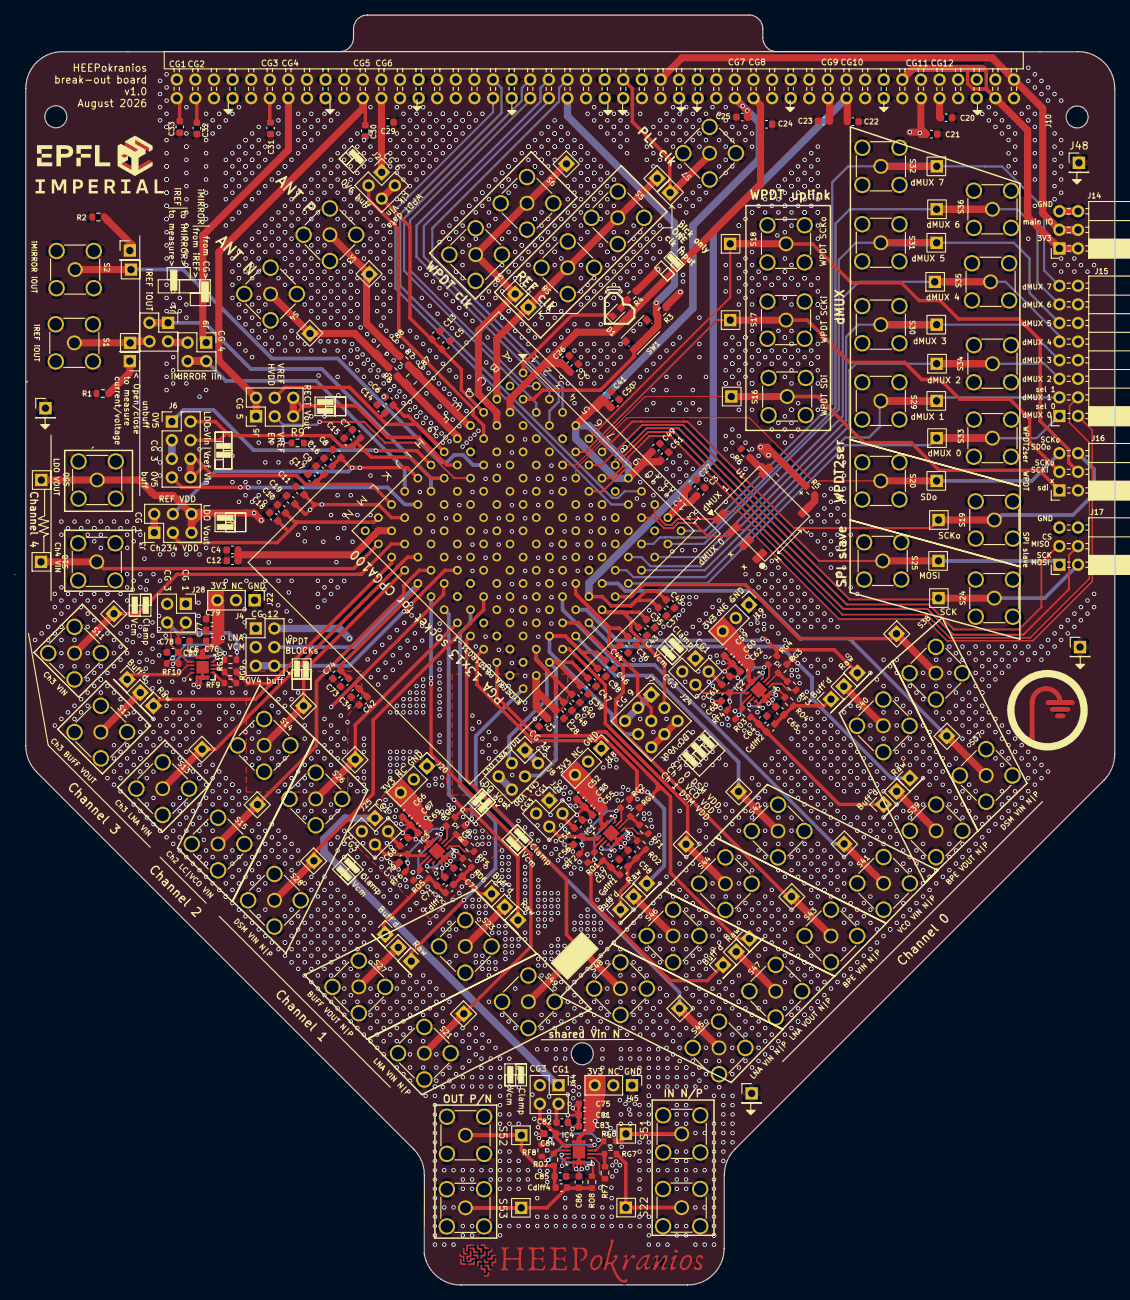
[picture p4: board heepokranios-bo.kicad_pcb from above]

Board: 4 copper layers, 150.1 x 173.4 mm, 235 parts (0 on the bottom side), 152 nets.
