esl-epfl/HEEPokranios-breakout-board/gpio-playground/gpio-playground.kicad_pcb

## KiCad design gpio-playground/gpio-playground.kicad_pcb (2026-08-07)

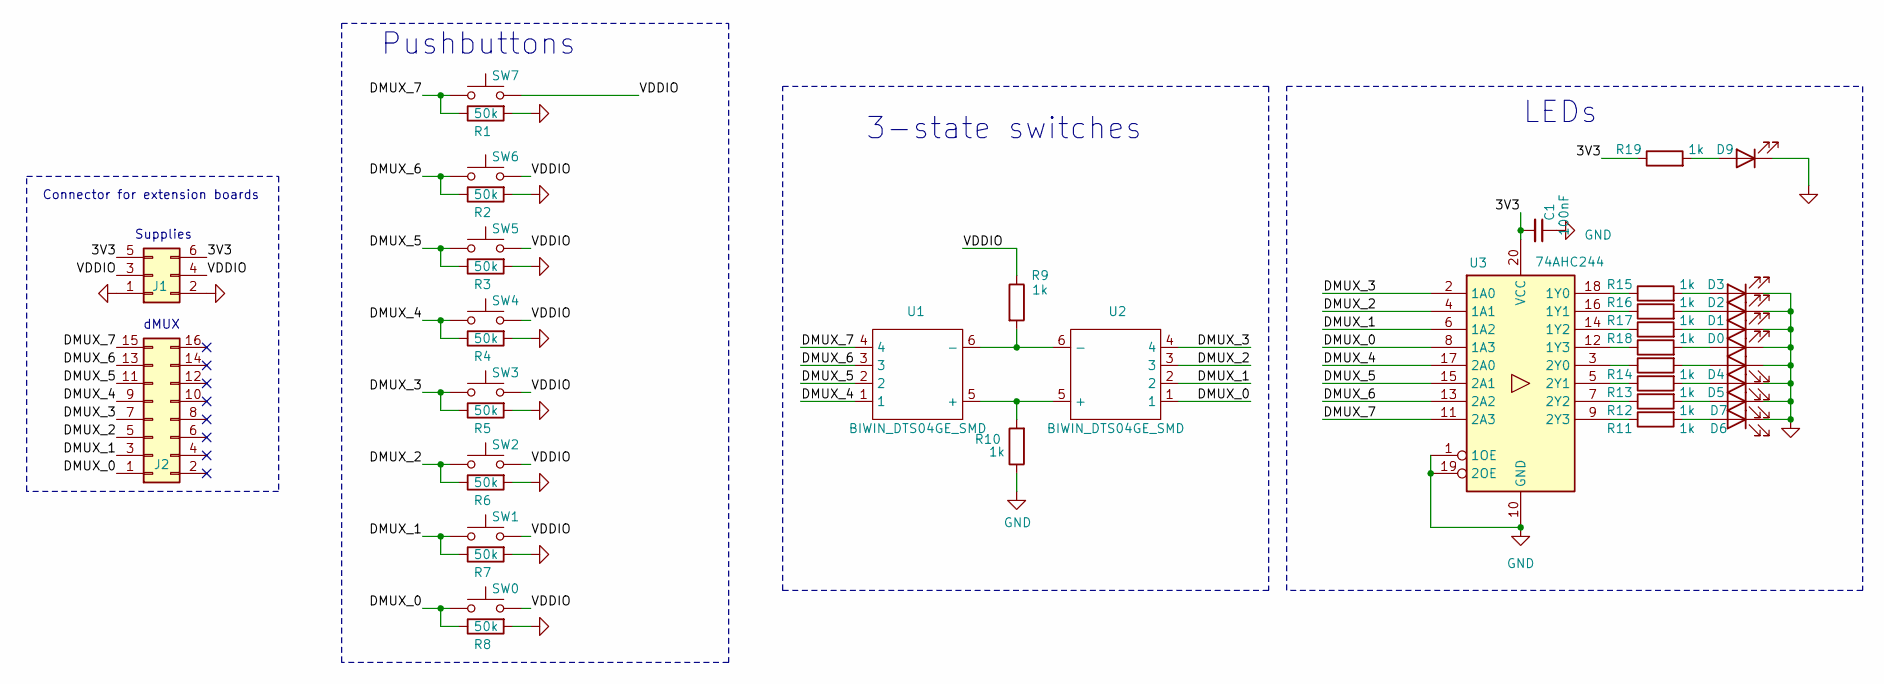
[picture p5: schematic gpio-playground.kicad_sch]

Parts:
C1: 100nF; C_0603_1608Metric; Mouser Part Number 80-C0805C104Z3V; Digikey Part Number 399-9158-1-ND
D0, D1, D2, D3, D4, D5, D6: LED; LED_0603_1608Metric; LCSC C965804
D7: LED; LED_0603_1608Metric; LCSC C84266
D9: LED; LED_0603_1608Metric; LCSC C84263
J1: Conn_02x03_Odd_Even; PinHeader_2x03_P2.54mm_Horizontal
J2: Conn_02x08_Odd_Even; PinHeader_2x08_P2.54mm_Horizontal
R1, R2, R3, R4, R5, R6, R7, R8: 50k; R_0603_1608Metric; LCSC C21190
R9, R10, R11, R12, R13, R14, R15, R16, R17, R18: 1k; R_0603_1608Metric; LCSC C21190
R19: 1k; R_0603_1608Metric; LCSC C22975
SW0, SW1, SW2, SW3, SW4, SW5, SW6, SW7: SW_Push; SW_Push_1P1T_NO_CK_KMR2; LCSC C221678
U1, U2: BIWIN_DTS04GE_SMD; lcsc C3294670
U3: 74AHC244; TSSOP-20_4.4x6.5mm_P0.65mm; LCSC C7475

Connections:
/3V3: C1.2, J1.5, J1.6, R19.1, U3.20 (VCC)
/DMUX_0: J2.1, R8.1, SW0.1, U2.1, U3.8 (1A3)
/DMUX_1: J2.3, R7.1, SW1.1, U2.2, U3.6 (1A2)
/DMUX_2: J2.5, R6.1, SW2.1, U2.3, U3.4 (1A1)
/DMUX_3: J2.7, R5.1, SW3.1, U2.4, U3.2 (1A0)
/DMUX_4: J2.9, R4.1, SW4.1, U1.1, U3.17 (2A0)
/DMUX_5: J2.11, R3.1, SW5.1, U1.2, U3.15 (2A1)
/DMUX_6: J2.13, R2.1, SW6.1, U1.3, U3.13 (2A2)
/DMUX_7: J2.15, R1.1, SW7.1, U1.4, U3.11 (2A3)
/VDDIO: J1.3, J1.4, R9.1, SW0.2, SW1.2, SW2.2, SW3.2, SW4.2, SW5.2, SW6.2, SW7.2
GND: C1.1, D0.1 (K), D1.1 (K), D2.1 (K), D3.1 (K), D4.1 (K), D5.1 (K), D6.1 (K), D7.1 (K), D9.1 (K), J1.1, J1.2, R1.2, R2.2, R3.2, R4.2, R5.2, R6.2, R7.2, R8.2, R10.1, U3.1 (1OE), U3.10 (GND), U3.19 (2OE)
unnamed: D0.2 (A), R18.2
unnamed: D1.2 (A), R17.2
unnamed: D2.2 (A), R16.2
unnamed: D3.2 (A), R15.2
unnamed: D4.2 (A), R14.2
unnamed: D5.2 (A), R13.2
unnamed: D6.2 (A), R12.2
unnamed: D7.2 (A), R11.2
unnamed: D9.2 (A), R19.2
unnamed: R10.2, U1.5 (+), U2.5 (+)
unnamed: R9.2, U1.6 (-), U2.6 (-)
unnamed: R15.1, U3.18 (1Y0)
unnamed: R16.1, U3.16 (1Y1)
unnamed: R17.1, U3.14 (1Y2)
unnamed: R18.1, U3.12 (1Y3)
unnamed: R14.1, U3.3 (2Y0)
unnamed: R13.1, U3.5 (2Y1)
unnamed: R12.1, U3.7 (2Y2)
unnamed: R11.1, U3.9 (2Y3)

Notes on the sheet:
Pushbuttons
Supplies
Connector for extension boards
dMUX
LEDs
3-state switches

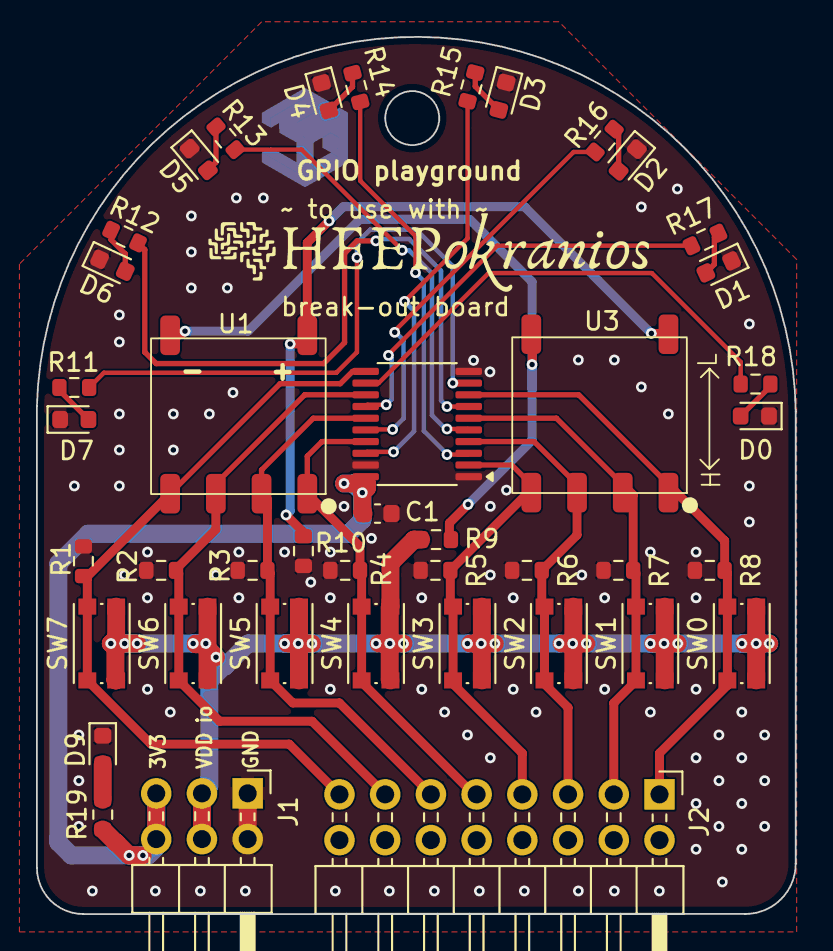
[picture p6: board gpio-playground.kicad_pcb from above]

Board: 2 copper layers, 42.2 x 48.7 mm, 42 parts (0 on the bottom side), 30 nets.
