esl-epfl/HEEPokranios-breakout-board/heepidermis-bo/heepidermis-bo.kicad_pcb

## KiCad design heepidermis-bo/heepidermis-bo.kicad_pcb (2025-10-01)

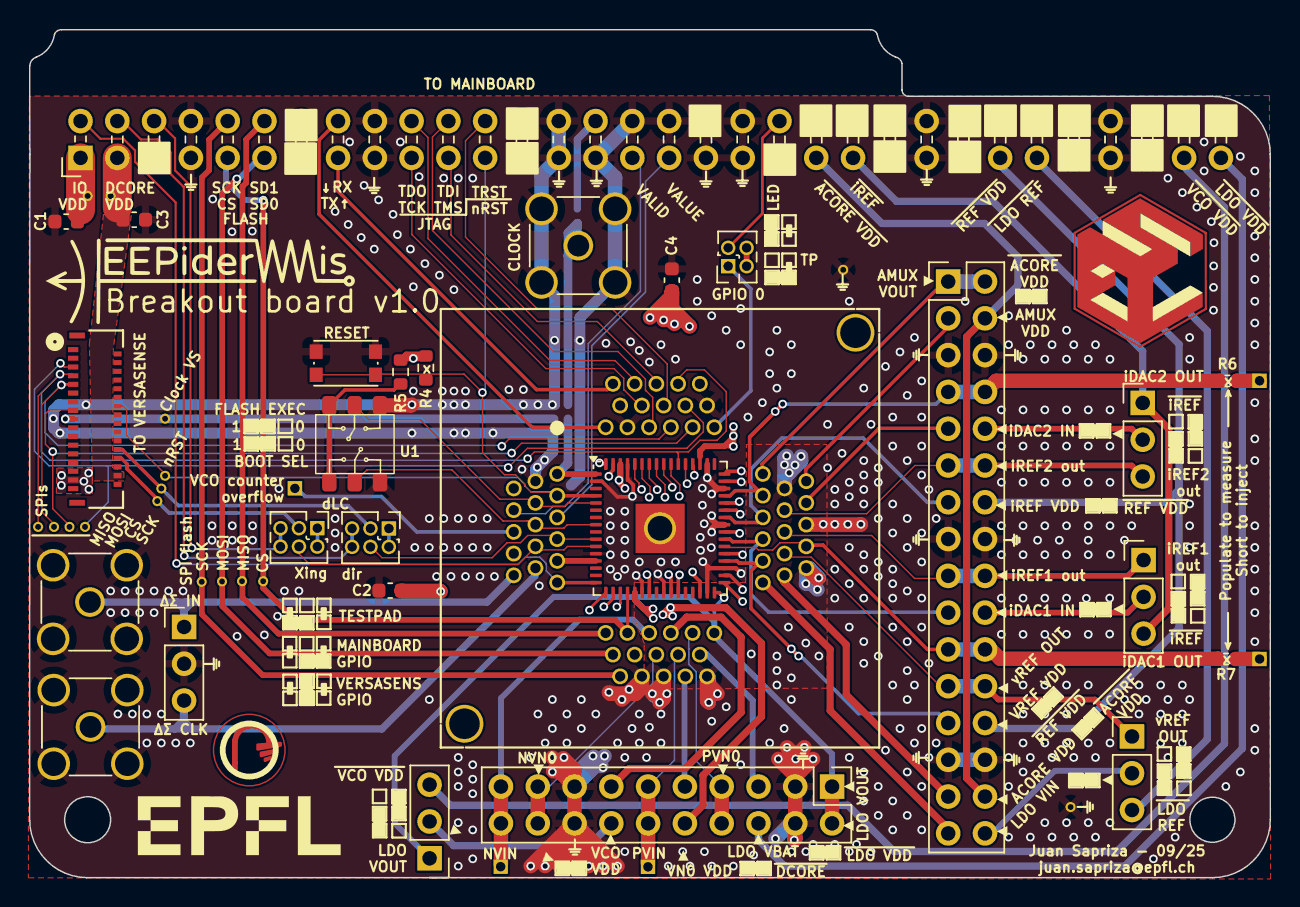
[picture p9: board heepidermis-bo.kicad_pcb from above]

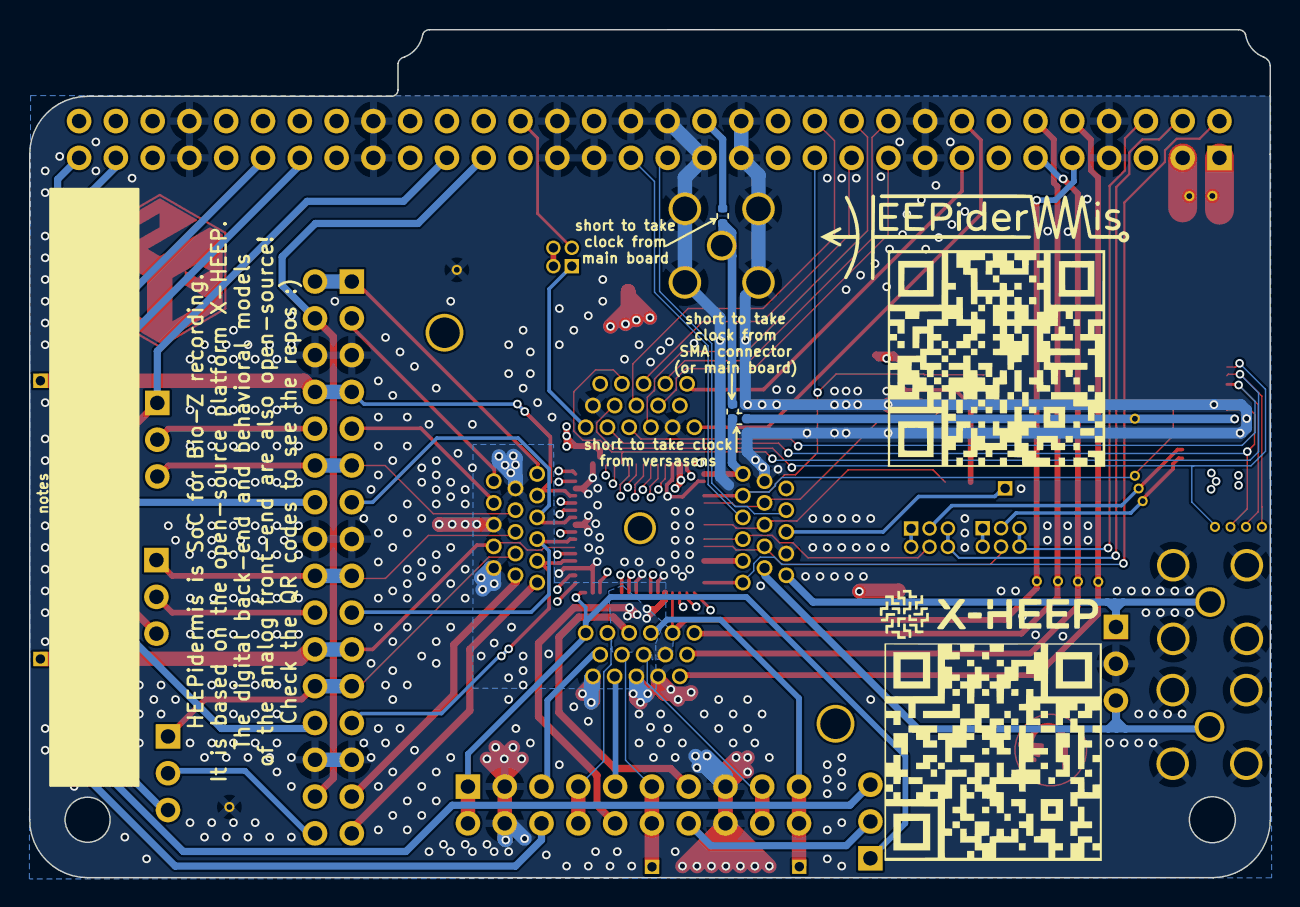
[picture p10: board heepidermis-bo.kicad_pcb from below]

Board: 4 copper layers, 85.7 x 58.5 mm, 51 parts (3 on the bottom side), 76 nets.

Parts:
C1, C2, C3, C4: 100n; C_0603_1608Metric
HEEPidermis1: 264-5205-01; CONN_5205_3MM
HEEPidermis2: 264-5205-01; QFN-64-1EP_9x9mm_P0.5mm_EP3.4x3.4mm
J1, J14, J18, J21, J22: Conn_01x03; PinHeader_1x01_P1.27mm_Vertical
J2: 5025983393; CONN_502598-3393_MOL
J3, J4, J16, J24, J25, J26, J27, J28, J29, J30, J31, J32, J33, J34, J35, J36: Conn_01x03; TestPoint_THTPad_1.0x1.0mm_Drill0.5mm
J5, J6: Conn_01x03; PinHeader_2x03_P1.27mm_Vertical
J7, J12, J13, J19, J20: Conn_01x03; PinHeader_1x03_P2.54mm_Vertical
J8: Conn_01x03; PinHeader_2x02_P1.27mm_Vertical
J9, J10, J11: Conn_Boaxial; SMA_Amphenol_901-144_Vertical
J15: Conn_02x16_Odd_Even; PinHeader_2x16_P2.54mm_Vertical
J17: Conn_02x10_Odd_Even; PinHeader_2x10_P2.54mm_Vertical
J23: Conn_02x29_Top_Bottom; PinHeader_2x32_P2.54mm_Horizontal
R1, R2, R3, R6, R7: 0R; R_0402_1005Metric
R4: 1k; R_0603_1608Metric
R5: 10k; R_0603_1608Metric
SW1: SW_Push; SW_Push_1P1T_NO_CK_KMR2
U1: SPDT-2pos-CAS-D20B1

Connections:
/ACORE_VDD: HEEPidermis1.34, HEEPidermis2.34, J15.29
/AMUX_VDD: HEEPidermis1.47, HEEPidermis2.47, J15.3
/AMUX_VOUT: HEEPidermis1.48, HEEPidermis2.48, J15.1, J15.2
/BOOT_SEL: HEEPidermis1.8, HEEPidermis2.8, U1.2 (B)
/CLOCK: HEEPidermis1.1, HEEPidermis2.1, R1.1, R2.2
/CLOCK_coaxial: J11.1 (In), R2.1, R3.2
/CLOCK_main: J23.30, R3.1
/CLOCK_vs: J2.17, J36.1, R1.2
/DSM_CLK_GPIO_4: HEEPidermis1.14, J7.3, J9.1 (In)
/DSM_IN_GPIO_5: HEEPidermis1.15, J7.1, J10.1 (In)
/EXEC_FLASH: HEEPidermis1.5, HEEPidermis2.5, U1.5 (B)
/EXIT_VALID: HEEPidermis1.6, J23.31
/EXIT_VALUE: HEEPidermis1.7, J23.33
/GPIO.LED_B_1: J6.5, J6.6, J23.6
/GPIO.LED_R_1: J5.5, J5.6, J23.4
/GPIO.LED_R_2: J8.2, J23.40
/GPIO_0: HEEPidermis1.49, J8.1
/GPIO_0_ext: J8.3, J8.4
/GPIO_6: HEEPidermis1.16, HEEPidermis2.16, J23.2
/IDAC_1_IIN: HEEPidermis1.39, HEEPidermis2.39, J15.19
/IDAC_1_IOUT: HEEPidermis1.38, HEEPidermis2.38, J15.21, J15.22, R7.1
/IDAC_2_IIN: HEEPidermis1.44, HEEPidermis2.44, J15.9
/IDAC_2_IOUT: HEEPidermis1.45, HEEPidermis2.45, J15.7, J15.8, R6.1
/IREF_1_IOUT: HEEPidermis1.40, HEEPidermis2.40, J12.1, J15.17, J15.18
/IREF_2_IOUT: HEEPidermis1.43, HEEPidermis2.43, J13.3, J15.11, J15.12
/IREF_VDD: HEEPidermis1.42, HEEPidermis2.42, J15.13
/JTAG.TCK: HEEPidermis1.59, HEEPidermis2.59, J23.19
/JTAG.TDI: HEEPidermis1.58, HEEPidermis2.58, J23.22
/JTAG.TDO: HEEPidermis1.60, HEEPidermis2.60, J23.20
/JTAG.TMS: HEEPidermis1.57, HEEPidermis2.57, J23.21
/JTAG.TRST: HEEPidermis1.56, HEEPidermis2.56, J23.24
/LC_DIR_GPIO_2: HEEPidermis1.10, HEEPidermis2.10, J5.4
/LC_DIR_vs: J2.24, J5.3, J34.1
/LC_XING_GPIO_3: HEEPidermis1.11, HEEPidermis2.11, J6.4
/LC_XING_vs: J2.26, J6.3, J35.1
/LDO_VBAT: HEEPidermis1.30, HEEPidermis2.30, J17.5
/LDO_VIN: HEEPidermis1.33, HEEPidermis2.33, J15.31
/LDO_VOUT: HEEPidermis1.32, HEEPidermis2.32, J17.1, J17.2, J20.1
/SPI_FLASH.CS0: HEEPidermis1.20, HEEPidermis2.20, J23.9, J24.1
/SPI_FLASH.SCK: HEEPidermis1.19, HEEPidermis2.19, J16.1, J23.10
/SPI_FLASH.SD0: HEEPidermis1.18, HEEPidermis2.18, J4.1, J23.11
/SPI_FLASH.SD1: HEEPidermis1.17, HEEPidermis2.17, J3.1, J23.12
/SPI_S_CS: HEEPidermis1.52, HEEPidermis2.52, J2.15, J25.1
/SPI_S_MISO: HEEPidermis1.54, HEEPidermis2.54, J2.7, J27.1
/SPI_S_MOSI: HEEPidermis1.55, HEEPidermis2.55, J2.9, J28.1
/SPI_S_SCK: HEEPidermis1.53, HEEPidermis2.53, J2.5, J26.1
/SUPPLY_ACORE_VDD: J15.4, J15.30, J23.41
/SUPPLY_DCORE_VDD: C3.1, C4.1, HEEPidermis1.21, HEEPidermis1.51, HEEPidermis2.21, HEEPidermis2.51, J2.30, J17.10, J23.3, J32.1
/SUPPLY_IO_VDD: C1.1, C2.1, HEEPidermis1.13, HEEPidermis1.62, HEEPidermis2.13, HEEPidermis2.62, J2.31, J23.1, J31.1, R4.2, R5.2
/SUPPLY_IREF: J12.3, J13.1, J23.43
/SUPPLY_LDO_REF: J19.3, J23.53
/SUPPLY_LDO_VDD: J17.6, J23.63
/SUPPLY_REF_VDD: J15.14, J15.26, J23.51
/SUPPLY_VCO_VDD: J20.3, J23.61
/UART.RX: HEEPidermis1.64, HEEPidermis2.64, J23.16
/UART.TX: HEEPidermis1.63, HEEPidermis2.63, J23.15
/VCO_CNT_OVF: HEEPidermis1.9, J1.1
/VCO_N_VIN: HEEPidermis1.23, HEEPidermis2.23, J17.19, J17.20, J21.1
/VCO_N_VN0: HEEPidermis1.24, J17.17, J17.18
/VCO_P_VIN: HEEPidermis1.27, HEEPidermis2.27, J17.11, J17.12, J22.1
/VCO_P_VN0: HEEPidermis1.29, J17.7, J17.8
/VCO_VDD: HEEPidermis1.26, HEEPidermis2.26, J17.13
/VCO_VN0_VDD: HEEPidermis1.28, J17.9
/VREF_VDD: HEEPidermis1.36, HEEPidermis2.36, J15.25
/VREF_VOUT: HEEPidermis1.37, HEEPidermis2.37, J15.23, J15.24, J19.1
/nRST: HEEPidermis1.4, HEEPidermis2.4, J2.14, J23.23, J33.1, R4.1, SW1.1
GND: C1.2, C2.2, C3.2, C4.2, HEEPidermis1.2, HEEPidermis1.12, HEEPidermis1.22, HEEPidermis1.25, HEEPidermis1.31, HEEPidermis1.35, HEEPidermis1.41, HEEPidermis1.46, HEEPidermis1.50, HEEPidermis1.61, HEEPidermis2.2, HEEPidermis2.12, HEEPidermis2.22, HEEPidermis2.25, HEEPidermis2.31, HEEPidermis2.35, HEEPidermis2.41, HEEPidermis2.46, HEEPidermis2.50, HEEPidermis2.61, J7.2, J9.2 (Ext), J10.2 (Ext), J11.2 (Ext), J15.5, J15.6, J15.15, J15.16, J15.27, J15.28, J17.3, J17.4, J17.15, J17.16, J23.7, J23.8, J23.17, J23.18, J23.27, J23.28, J23.29, J23.32, J23.34, J23.35, J23.37, J23.38, J23.47, J23.48, J23.57, J23.58, J29.1, J30.1, SW1.2, U1.3 (C), U1.6 (C)
unnamed: J5.1, J5.2
unnamed: J6.1, J6.2
unnamed: J12.2, J15.20
unnamed: J13.2, J15.10
unnamed: J14.1, R6.2
unnamed: J15.32, J19.2
unnamed: J17.14, J20.2
unnamed: J18.1, R7.2
unnamed: R5.1, U1.1 (A), U1.4 (A)
